HexabitzPlatform/H0AR9x-Hardware/README.md

# H0AR91-Hardware
Hexabitz Sensor Hub Module Hardware Design
