HexabitzPlatform/H0AR9x-Hardware/Released/BOM/H0AR9.xlsx

Qty | Comment | Designator | Description | MFN | MPN | OCTOPART_URL
1 | FB-TDK_MMZ1608Y300BTA00 | FB1 | Ind chip Bead Multi-Layer 30 ohms 25% 100MHZ Ferrite 1,5A 0603Punched paper T/R | TDK | MMZ1608Y300BTA00 | https://octopart.com/mmz1608y300bta00-tdk-7906990?r=sp
1 | PINHD-1X3 | JP1 | Conn Unshrouded Header HDR 3 POS 2.54mm Solder ST Top Entry Thru-Hole Carton | TE Connectivity | 5-146281-3 | https://octopart.com/5-146281-3-te+connectivity+%2F+amp-39745942?r=sp
1 | PINHD-1X1 | J3 | PCB Header, Unshrouded, Thru 02 Straight Header, .101, AMPMODU Mod II Series | TE Connectivity | 87227-1 | https://octopart.com/87227-1-te+connectivity-39512052?r=sp
1 | 0.0R | R3 | RES SMD 0.0OHM JUMPER 1/10W 0603 | YAGEO [VR] | RC0603JR-070RL | https://octopart.com/rc0603jr-070rl-yageo-1241539?r=sp
6 | 100nF | C1,C4,C5,C10,C15,C17 | CAP CER 10% X7R 0603 | AVX CORPORATION | 0603YC104K4T2A | https://octopart.com/0603yc104k4t2a-avx+interconnect+%2F+elco-8120651
2 | 10K | R2,R8 | RES 10 K OHM 5% 0603 | Vishay | CRCW060310K0JNEB | https://octopart.com/crcw060310k0jneb-vishay-46603269
3 | 1uF | C6,C13,C18 | CAP CER 1UF 16V X7R 0805 | YAGEO [VA] | CC0805KKX7R7BB105 | https://octopart.com/cc0805kkx7r7bb105-yageo-8376555?r=sp
2 | 2.2K | R4,R5 | RES 2.20K OHM 1/10W 1% 0603 SMD | Yageo | RC0603FR-072K2L | https://octopart.com/rc0603fr-072k2l-yageo-1214512?r=sp
1 | 22R | R9 | Res Thick Film 1210 22 Ohm 5% 1/2W ±200ppm/°C Molded SMD SMD Embossed Carrier T/R | Panasonic | ERJ-T14J220U | https://octopart.com/erj-t14j220u-panasonic-44403795?r=sp
1 | 22uF | C12 | Cap Tant Solid 22uF 10V B CASE 10% (3.5 X 2.8 X 1.9mm) SMD 3528-21 2.3 Ohm 125C T/R | Kemet | T491B226K010AT | https://octopart.com/t491b226k016at-kemet-96457?r=sp
1 | 270R | R1 | Thick Film Resistors - SMD 0603 270ohms 5% Tol | Panasonic | ERJ-3GEYJ271V | https://octopart.com/erj-3geyj271v-panasonic-55560546?r=sp
4 | 4.7uF | C2,C3,C11,C16 | CAP TANT 4.7UF 10V 20% 0805 | Panasonic | 10TPU4R7MSI | https://octopart.com/10tpu4r7msi-panasonic-29487748?r=sp
1 | XTALL_CSTCE8M00G52 | X1 | 8,0000MHZ 33pF SMD MURATA Resonators | Murata | CSTNE8M00G550000R0 | https://octopart.com/cstne8m00g550000r0-murata-91406934?r=sp
1 | BROADCOM_APDS-9950BROADCOM_APDS-9950_0_0 | U3 | Digital Ambient Light and Proximity Sensor 8-Pin SMD T/R | Broadcom | APDS-9950 | https://octopart.com/apds-9950-avago-39384905
1 | PANASONIC_EKMC1601111PANASONIC_EKMC1601111_0_0 | U2 | Board Mount Motion & Position Sensors Digital 170uA 5m White | Panasonic | EKMC1601111 | https://octopart.com/ekmc1601111-panasonic-18986132?r=sp
1 | RED | D1 | Red 0603 130آ° Clear 54 mcd 2 V Surface Mount ChipLED ; | Vishay | VLMS1300-GS08 | https://octopart.com/vlms1300-gs08-vishay-21709201?r=sp&s=0nXJNjGsSbWwqfqWlZv0EA
1 | STM32G0B1CEU6N | U1 | MCU 32-Bit ARM Cortex-M0+ RISC 512kByte Flash 1.7V to 3.6V 48-Pin UFQFPN Tray | STMicroelectronics | STM32G0B1CEU6N | https://octopart.com/stm32g0b1ceu6n-stmicroelectronics-116364672?r=sp
1 | TEXAS_INSTRUMENTS_HDC1080DMBT1TEXAS_INSTRUMENTS_HDC1080DMBT_0_1 | U4 | HDC1080 Low Power | Texas Instruments | HDC1080DMBT | https://octopart.com/hdc1080dmbt-texas+instruments-68058746?r=sp
