HexabitzPlatform/H0AR9x-Hardware/Documentation/H0AR9 Schematics.pdf

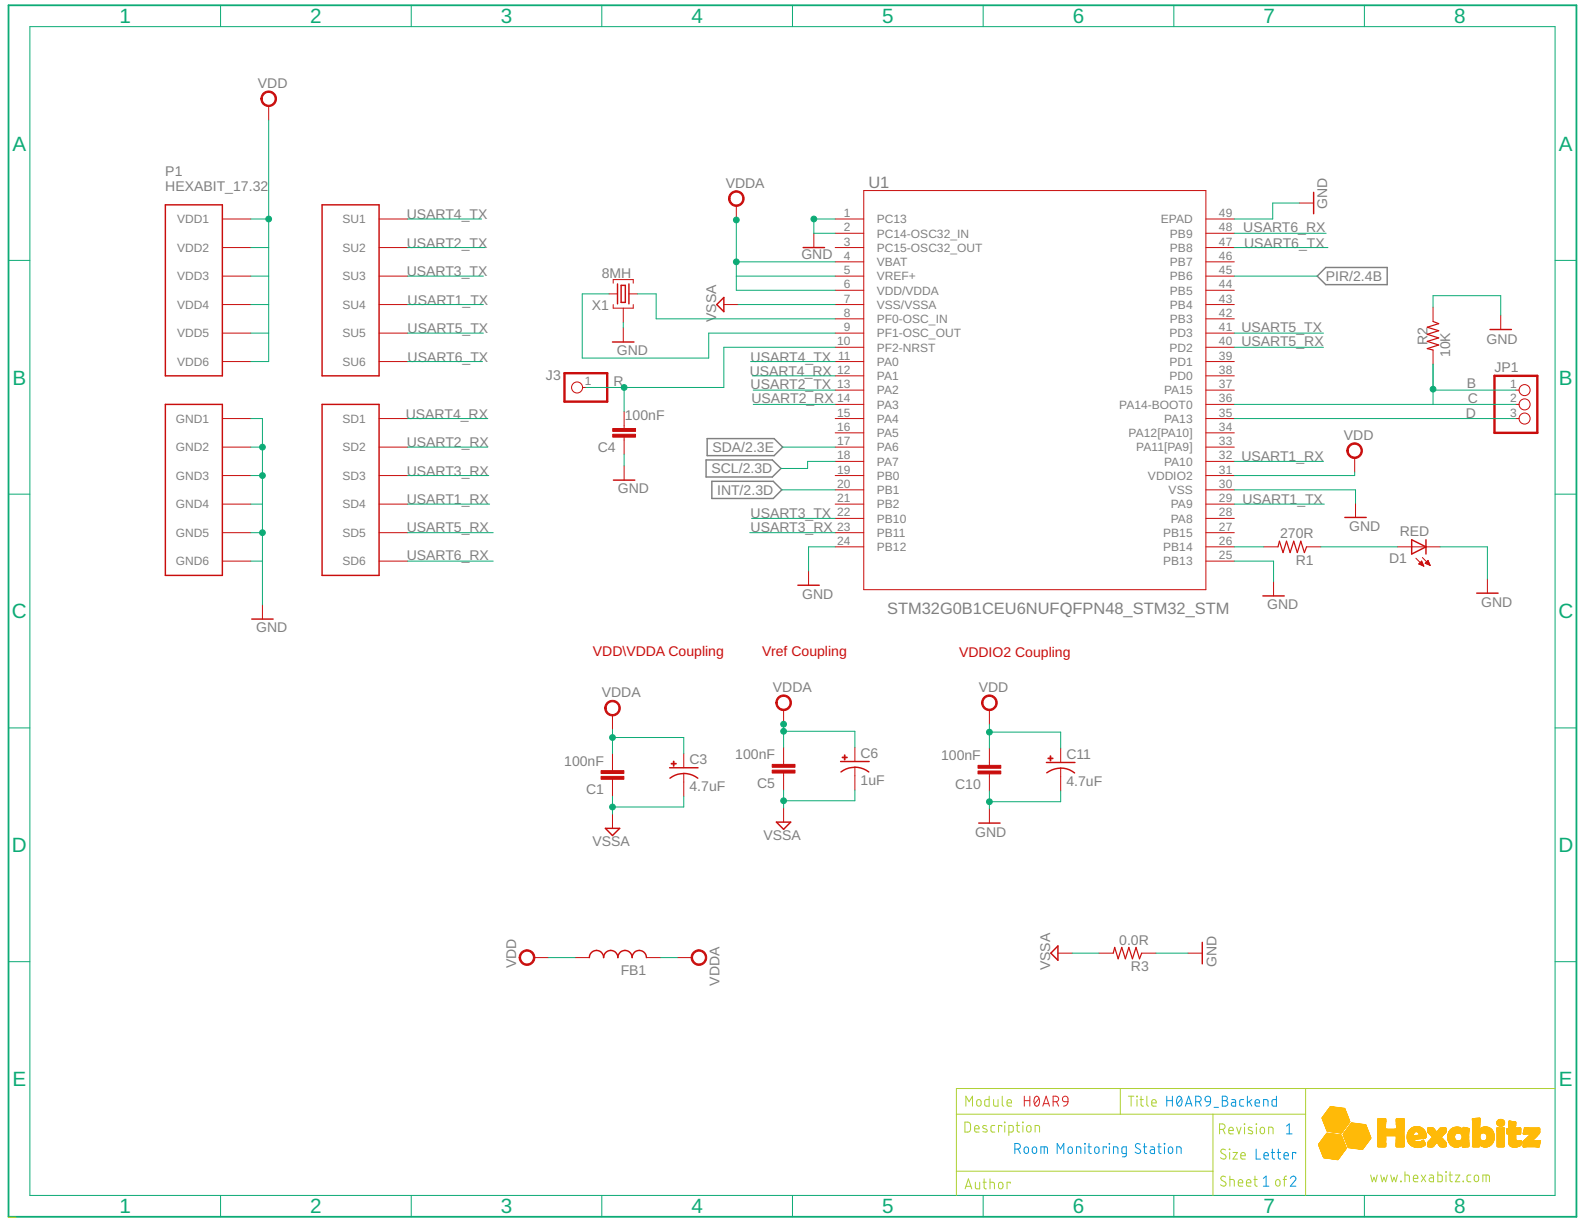
[picture p1: page 1]

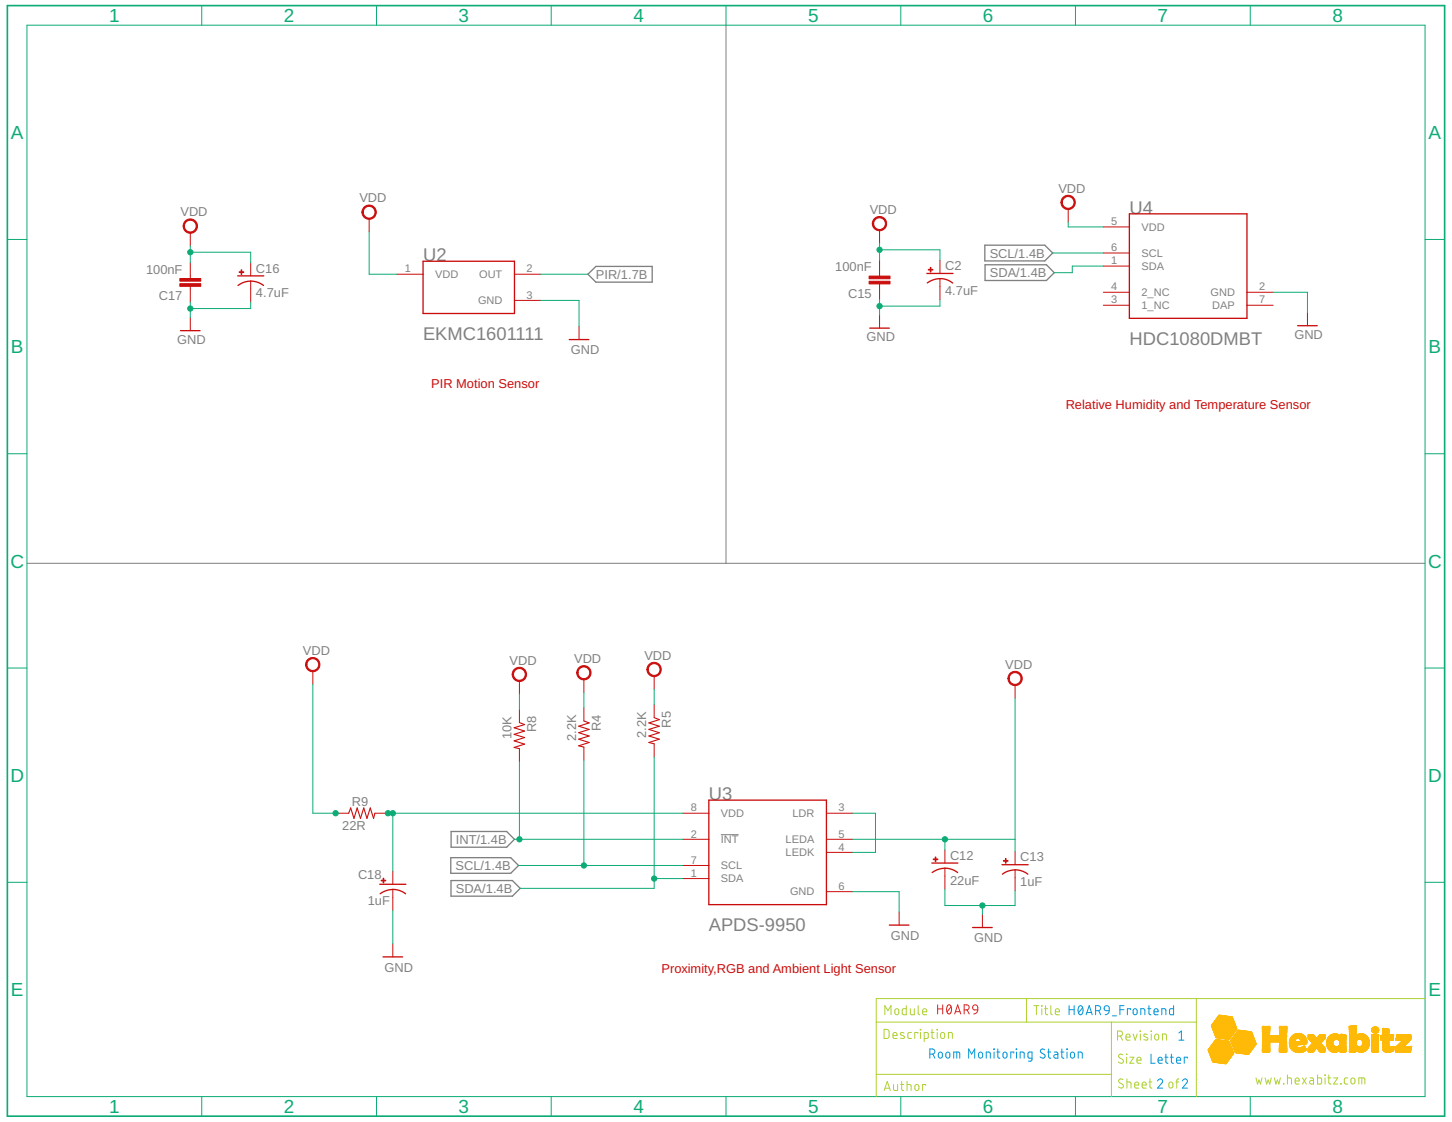
[picture p2: page 2]

VDD | VDD

Proximity,RGB and Ambient Light Sensor
