HexabitzPlatform/H0AR9x-Hardware/Design/H0AR9.brd

## EAGLE design Design/H0AR9.brd (2022-04-30)

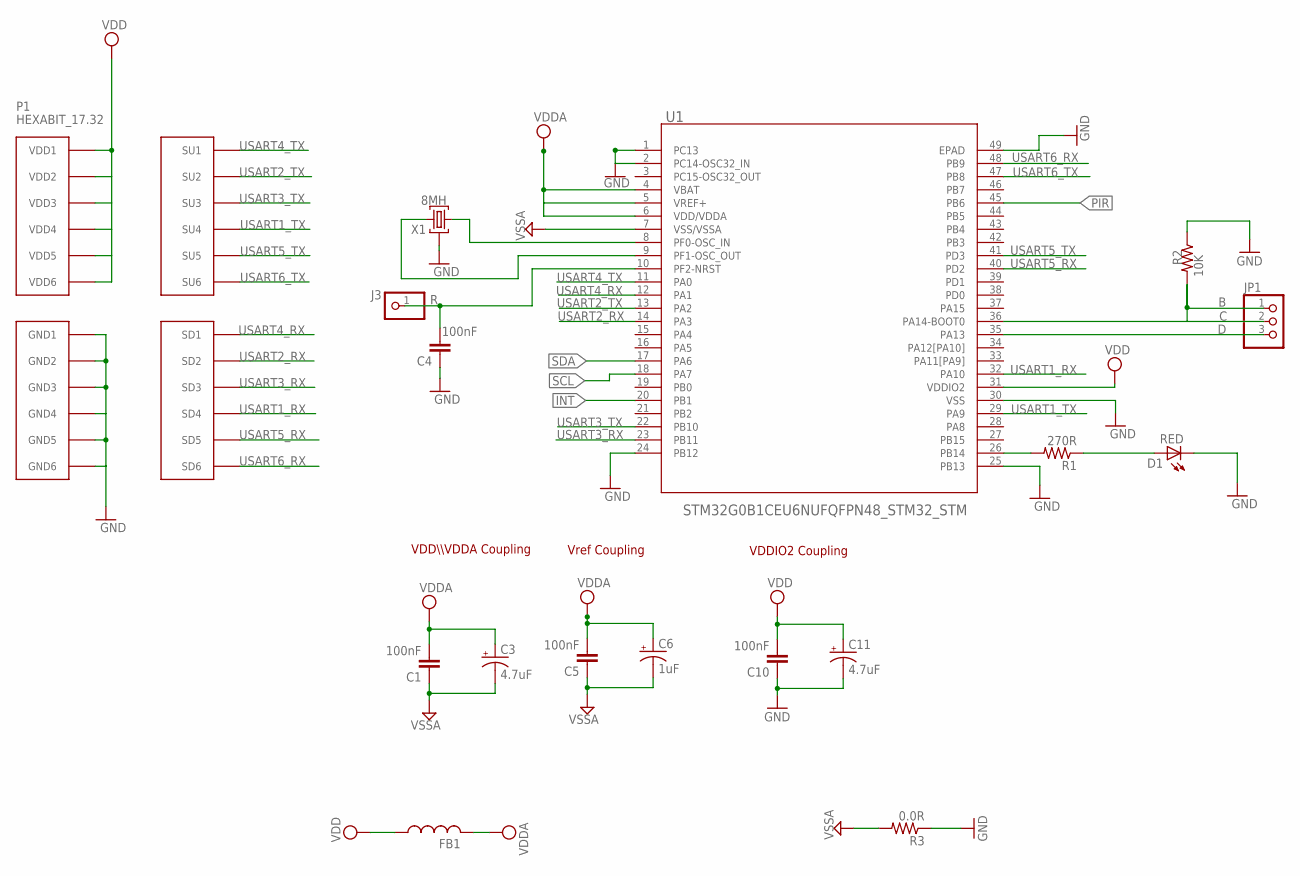
[picture p3: schematic H0AR9.sch, sheet 1]

Parts:
C1, C4, C5, C10: 100nF; C-0603; TOLERANCE 10%; VOLTAGE_RATING 16.0 V; MPN '0603YC104K4T2A
C3: 4.7uF; C-0805-POL; TOLERANCE 20%; VOLTAGE_RATING 10.0 V; MPN 10TPU4R7MSI
C6: 1uF; C-0805-POL; TOLERANCE 20%; VOLTAGE_RATING 10.0 V; MPN 'CC0805KKX7R7BB105
C11: 4.7uF; C-0805-POL; TOLERANCE 10%; VOLTAGE_RATING 16.0 V; MPN '10TPU4R7MSI
D1: RED; VLMS1300-GS08
FB1: FB-TDK_MMZ1608Y300B; MPN MMZ1608Y300BTA00
J3: PINHD-1X1; 1X01
JP1: PINHD-1X3; 1X03
P1: HEXABIT_17.32
R1: 270R; R-0603; MPN 'ERJ-3GEYJ271V
R2: 10K; R-0603; MPN '060300J0103T5E
R3: 0.0R; R-0603; MPN RC0603JR-070RL
U1: STM32G0B1CEU6NUFQFPN48_STM32_STM; UFQFPN48_STM32_STM
X1: 8MH; XTALL_CSTCE8M00G52; MPN CSTNE8M00G550000R0

Connections:
C: JP1.1, JP1.2, R2.2, U1.36 (PA14-BOOT0)
D: JP1.3, U1.35 (PA13)
GND: C4.1, C10.1, C11.2 (-), D1.C, P1.PAD_PD7 (GND1), P1.PAD_PD8 (GND2), P1.PAD_PD9 (GND3), P1.PAD_PD10 (GND4), P1.PAD_PD11 (GND5), P1.PAD_PD12 (GND6), R2.1, R3.1, U1.1 (PC13), U1.2 (PC14-OSC32_IN), U1.24 (PB12), U1.25 (PB13), U1.30 (VSS), U1.49 (EPAD), X1.P$2 (2); also elsewhere on the board
GND1: C1.1, C3.2 (-), C5.1, C6.2 (-), R3.2, U1.7 (VSS/VSSA)
INT: U1.20 (PB1); also elsewhere on the board
unnamed: U1.8 (PF0-OSC_IN), X1.P$3 (3)
unnamed: U1.9 (PF1-OSC_OUT), X1.P$1 (1)
unnamed: R1.2, U1.26 (PB14)
unnamed: D1.A, R1.1
PIR: U1.45 (PB6); also elsewhere on the board
R: C4.2, J3.1, U1.10 (PF2-NRST)
SCL: U1.18 (PA7); also elsewhere on the board
SDA: U1.17 (PA6); also elsewhere on the board
USART1_RX: P1.PAD_PD4 (SD4), U1.32 (PA10)
USART1_TX: P1.PAD_PU4 (SU4), U1.29 (PA9)
USART2_RX: P1.PAD_PD2 (SD2), U1.14 (PA3)
USART2_TX: P1.PAD_PU2 (SU2), U1.13 (PA2)
USART3_RX: P1.PAD_PD3 (SD3), U1.23 (PB11)
USART3_TX: P1.PAD_PU3 (SU3), U1.22 (PB10)
USART4_RX: P1.PAD_PD1 (SD1), U1.12 (PA1)
USART4_TX: P1.PAD_PU1 (SU1), U1.11 (PA0)
USART5_RX: P1.PAD_PD5 (SD5), U1.40 (PD2)
USART5_TX: P1.PAD_PU5 (SU5), U1.41 (PD3)
USART6_RX: P1.PAD_PD6 (SD6), U1.48 (PB9)
USART6_TX: P1.PAD_PU6 (SU6), U1.47 (PB8)
VCC: C1.2, C3.1 (+), C5.2, C6.1 (+), FB1.2, U1.4 (VBAT), U1.5 (VREF+), U1.6 (VDD/VDDA)
VDD: C10.2, C11.1 (+), FB1.1, P1.PAD_PU7 (VDD1), P1.PAD_PU8 (VDD2), P1.PAD_PU9 (VDD3), P1.PAD_PU10 (VDD4), P1.PAD_PU11 (VDD5), P1.PAD_PU12 (VDD6), U1.31 (VDDIO2); also elsewhere on the board

Notes on the sheet:
VDDIO2 Coupling
VDD\\\VDDA Coupling
Vref Coupling

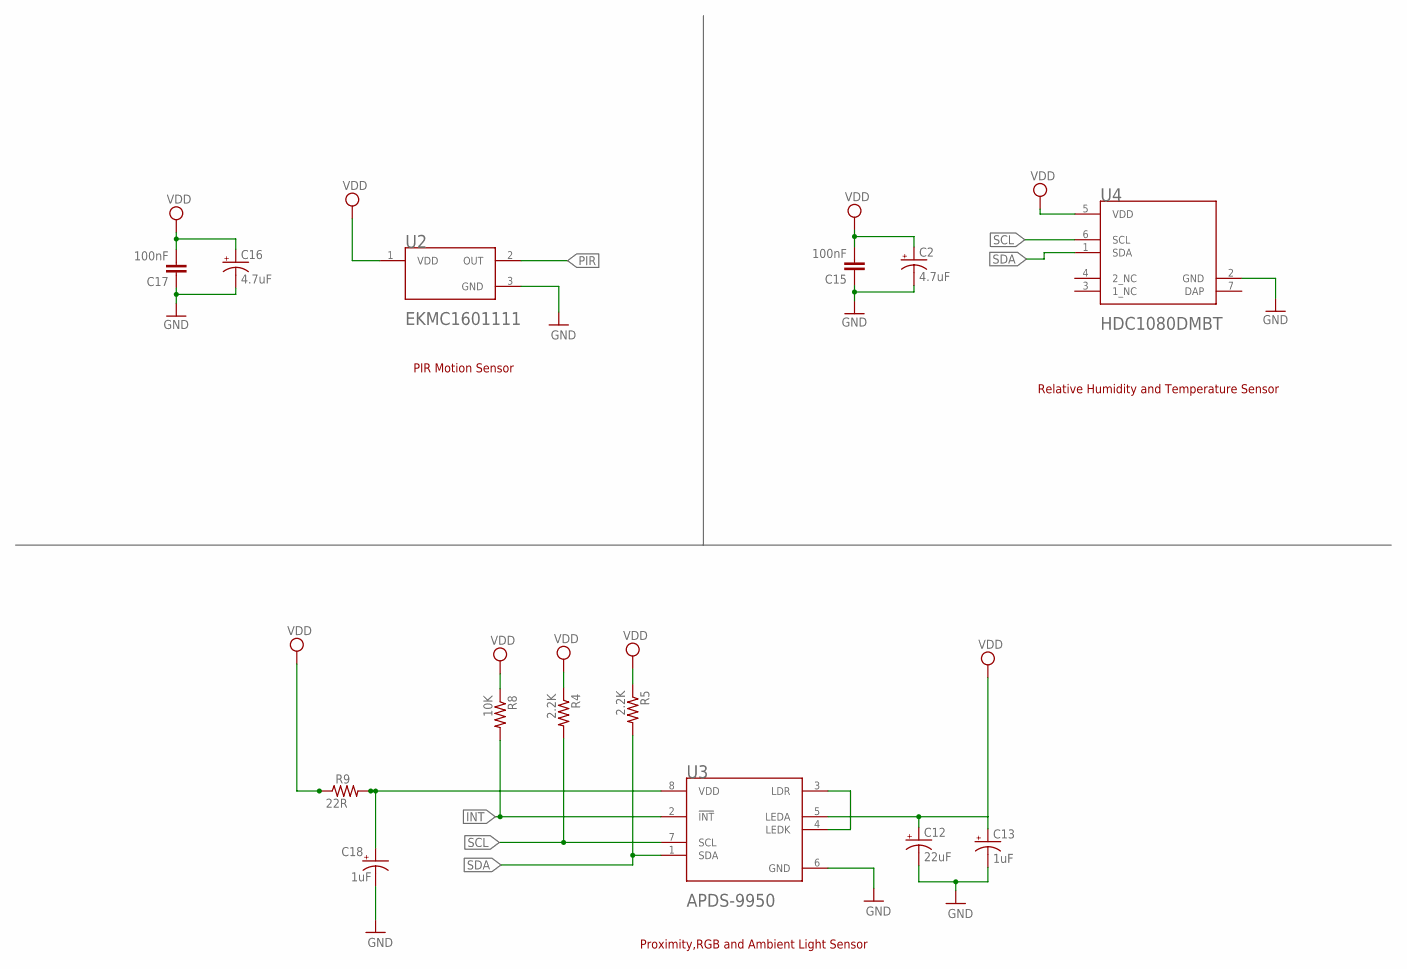
[picture p4: schematic H0AR9.sch, sheet 2]

Parts:
C2, C16: 4.7uF; C-0805-POL; TOLERANCE 20%; VOLTAGE_RATING 10.0 V; MPN 10TPU4R7MSI
C12: 22uF; C-0805-POL; TOLERANCE 20%; VOLTAGE_RATING 10.0 V; MPN T491B226K01AT
C13, C18: 1uF; C-0805-POL; TOLERANCE 20%; VOLTAGE_RATING 10.0 V; MPN 'CC0805KKX7R7BB105
C15, C17: 100nF; C-0603; TOLERANCE 10%; VOLTAGE_RATING 16.0 V; MPN '0603YC104K4T2A
R4, R5: 2.2K; R-0603; TOLERANCE 5%; MPN RC0603FR-072K2L
R8: 10K; R-0603; TOLERANCE 5%; MPN '060300J0103T5E
R9: 22R; R1210
U2: PANASONIC_EKMC1601111PANASONIC_EKMC1601111_0_0; PANASONIC_EKMC1601111_0
U3: BROADCOM_APDS-9950BROADCOM_APDS-9950_0_0; BROADCOM_APDS-9960_0
U4: TEXAS_INSTRUMENTS_HDC1080DMBT1TEXAS_INSTRUMENTS_H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; TEXAS_INSTRUMENTS_HDC1080DMBT_1

Connections:
DAP: U4.7 (DAP)
GND: C2.2 (-), C12.2 (-), C13.2 (-), C15.1, C16.2 (-), C17.1, C18.2 (-), U2.3 (GND), U3.6 (GND), U4.2 (GND); also elsewhere on the board
INT: R8.2, U3.2 (!INT!); also elsewhere on the board
unnamed: U3.3 (LDR), U3.4 (LEDK)
unnamed: C18.1 (+), R9.2, U3.8 (VDD)
PIR: U2.2 (OUT); also elsewhere on the board
SCL: R4.2, U3.7 (SCL), U4.6 (SCL); also elsewhere on the board
SDA: R5.2, U3.1 (SDA), U4.1 (SDA); also elsewhere on the board
VDD: C2.1 (+), C12.1 (+), C13.1 (+), C15.2, C16.1 (+), C17.2, R4.1, R5.1, R8.1, R9.1, U2.1 (VDD), U3.5 (LEDA), U4.5 (VDD); also elsewhere on the board

Notes on the sheet:
Proximity,RGB and Ambient Light Sensor
PIR Motion Sensor
Relative Humidity and Temperature Sensor

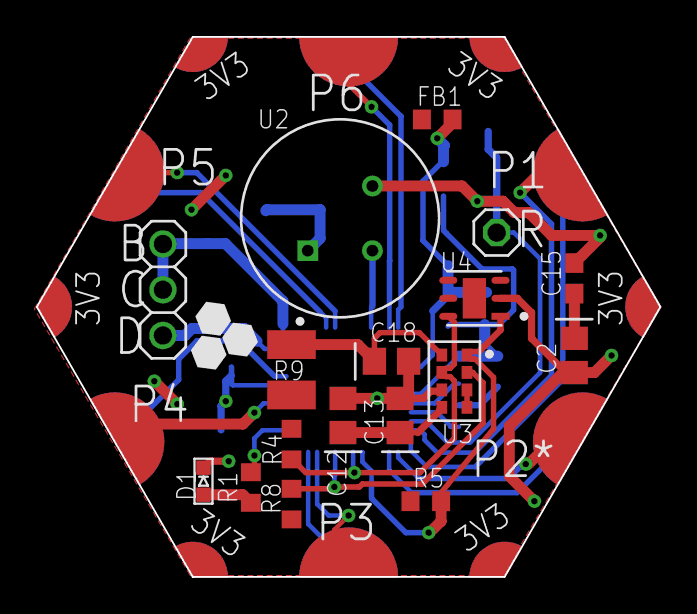
[picture p5: board H0AR9.brd from above]

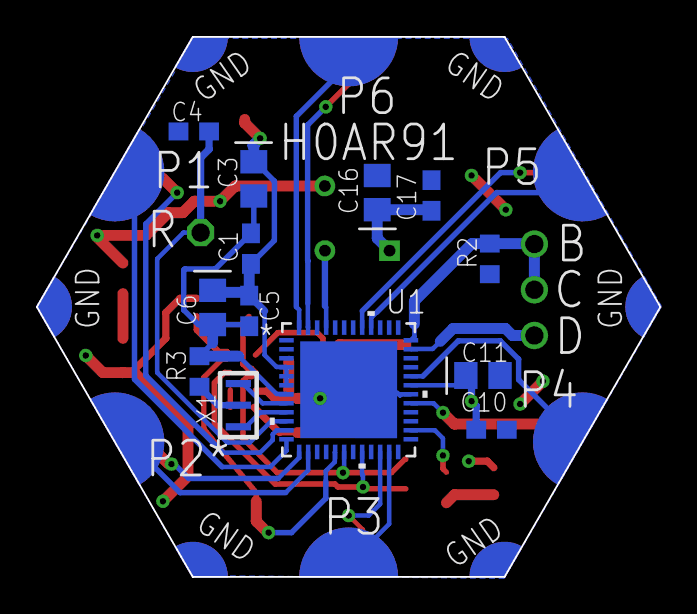
[picture p6: board H0AR9.brd from below]

Board: 2 copper layers, 34.6 x 30.0 mm, 31 parts (13 on the bottom side), 29 nets.
