HexabitzPlatform/H0AR9x-Hardware/(commit log)

2022-04-30 -Changing the MC with STM32G0
    [H0AR91.brd, H0AR91.sch, H0AR91_BOM.xlsx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]
2022-08-23 Correct Schematic file
2023-02-15 -Correcting some documentaion issues
    [H0AR91.sch, H0AR91_BOM.xlsx]
2024-01-02 -Standarize the files and folders
    [H0AR9.brd, H0AR9.sch, H0AR9.xlsx, H0AR91_BOM.xlsx]
