HexabitzPlatform/H0AR9x-Hardware/(notices)

Notices in the files:
parts and their libraries:
HEXABITZ_ICs: COPYRIGHT: Copyright (C) 2022 Ultra Librarian. All rights reserved.
